YetAnotherElectronicsChannel/Discrete-PWM-Class-D/spice_filter_simulation.pdf

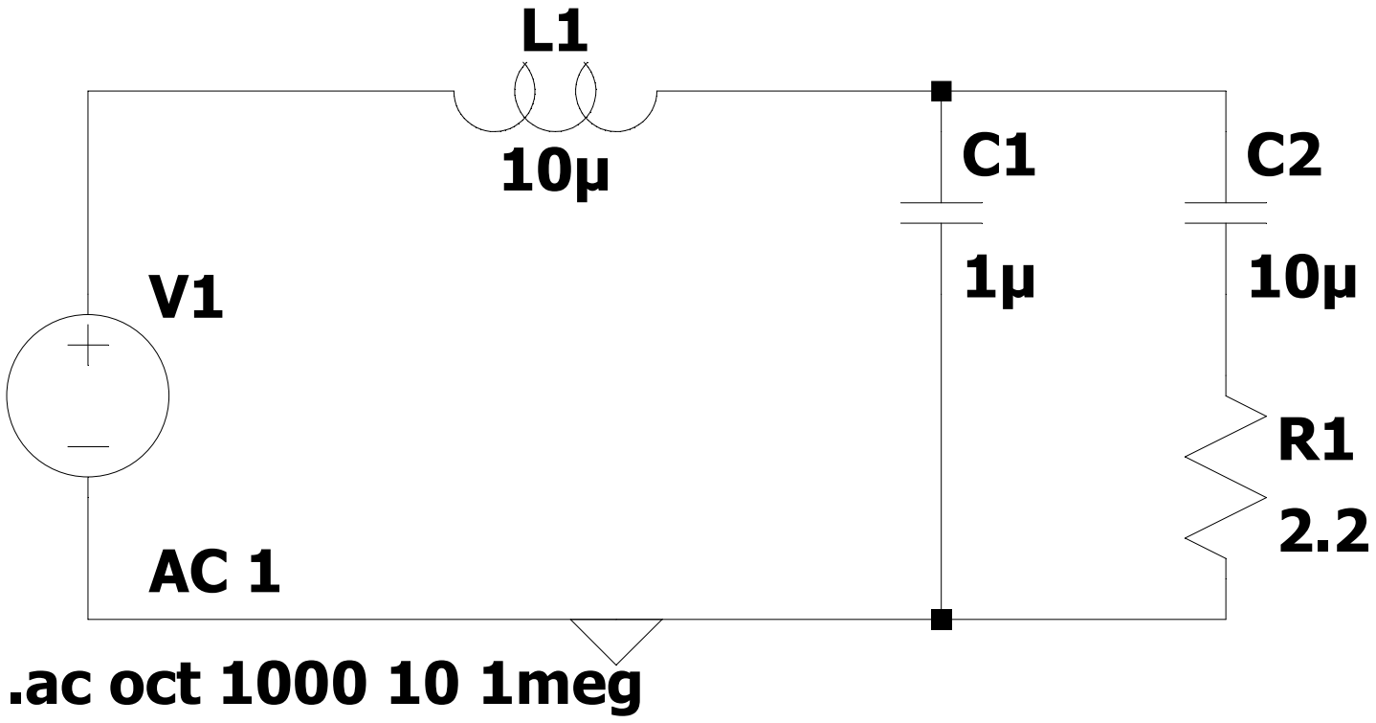
[picture p2: figure]
.ac oct 1000 10 1meg

--- E:\spice\youtube_classd_filter.asc ---
