YetAnotherElectronicsChannel/Discrete-PWM-Class-D/PWM Class-D Concept.pdf

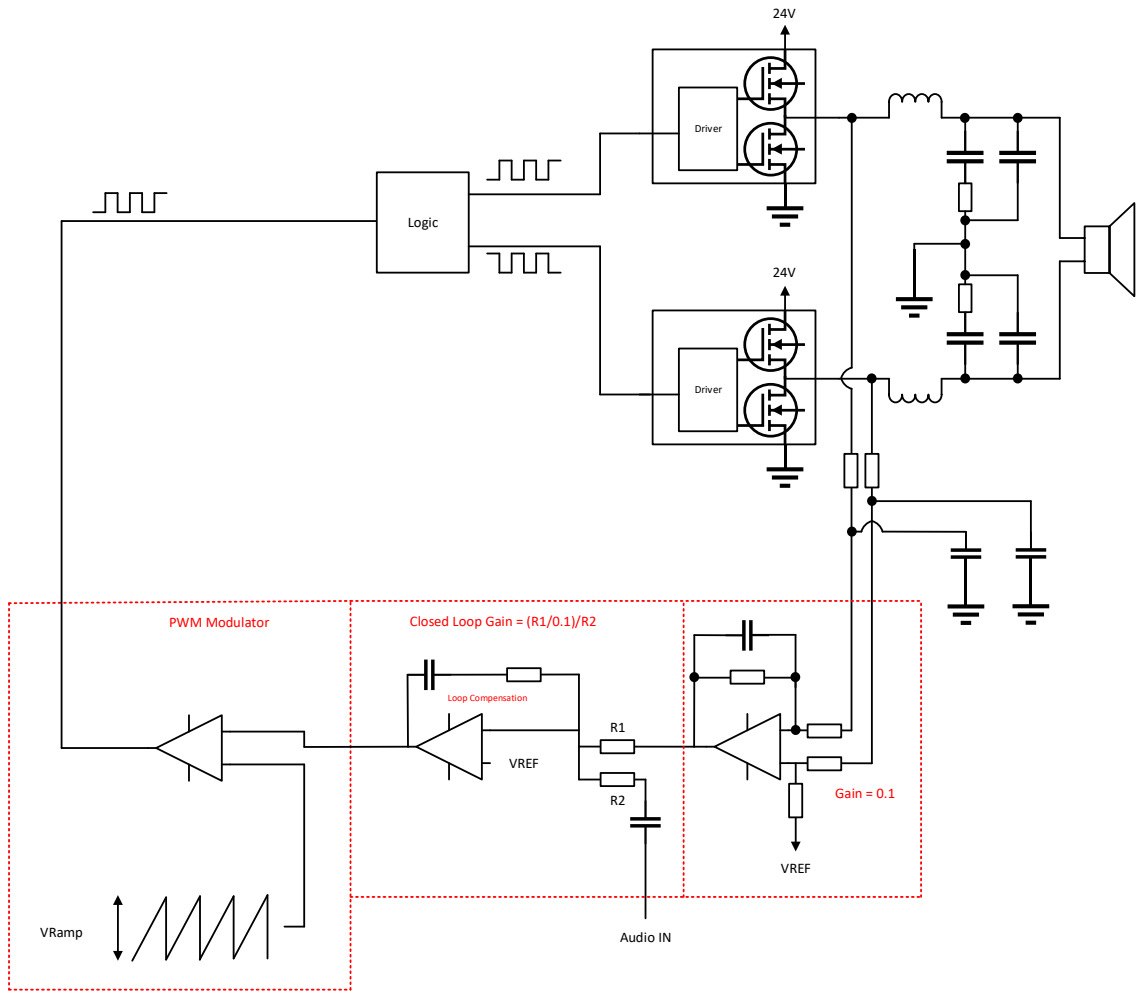
[picture p3: page 1]
Driver; VREF; Audio IN; Gain = 0.1; Loop Compensation; VRamp; Logic; PWM Modulator

Closed Loop Gain = (R1/0.1)/R2
