YetAnotherElectronicsChannel/Discrete-PWM-Class-D/Schematic.pdf

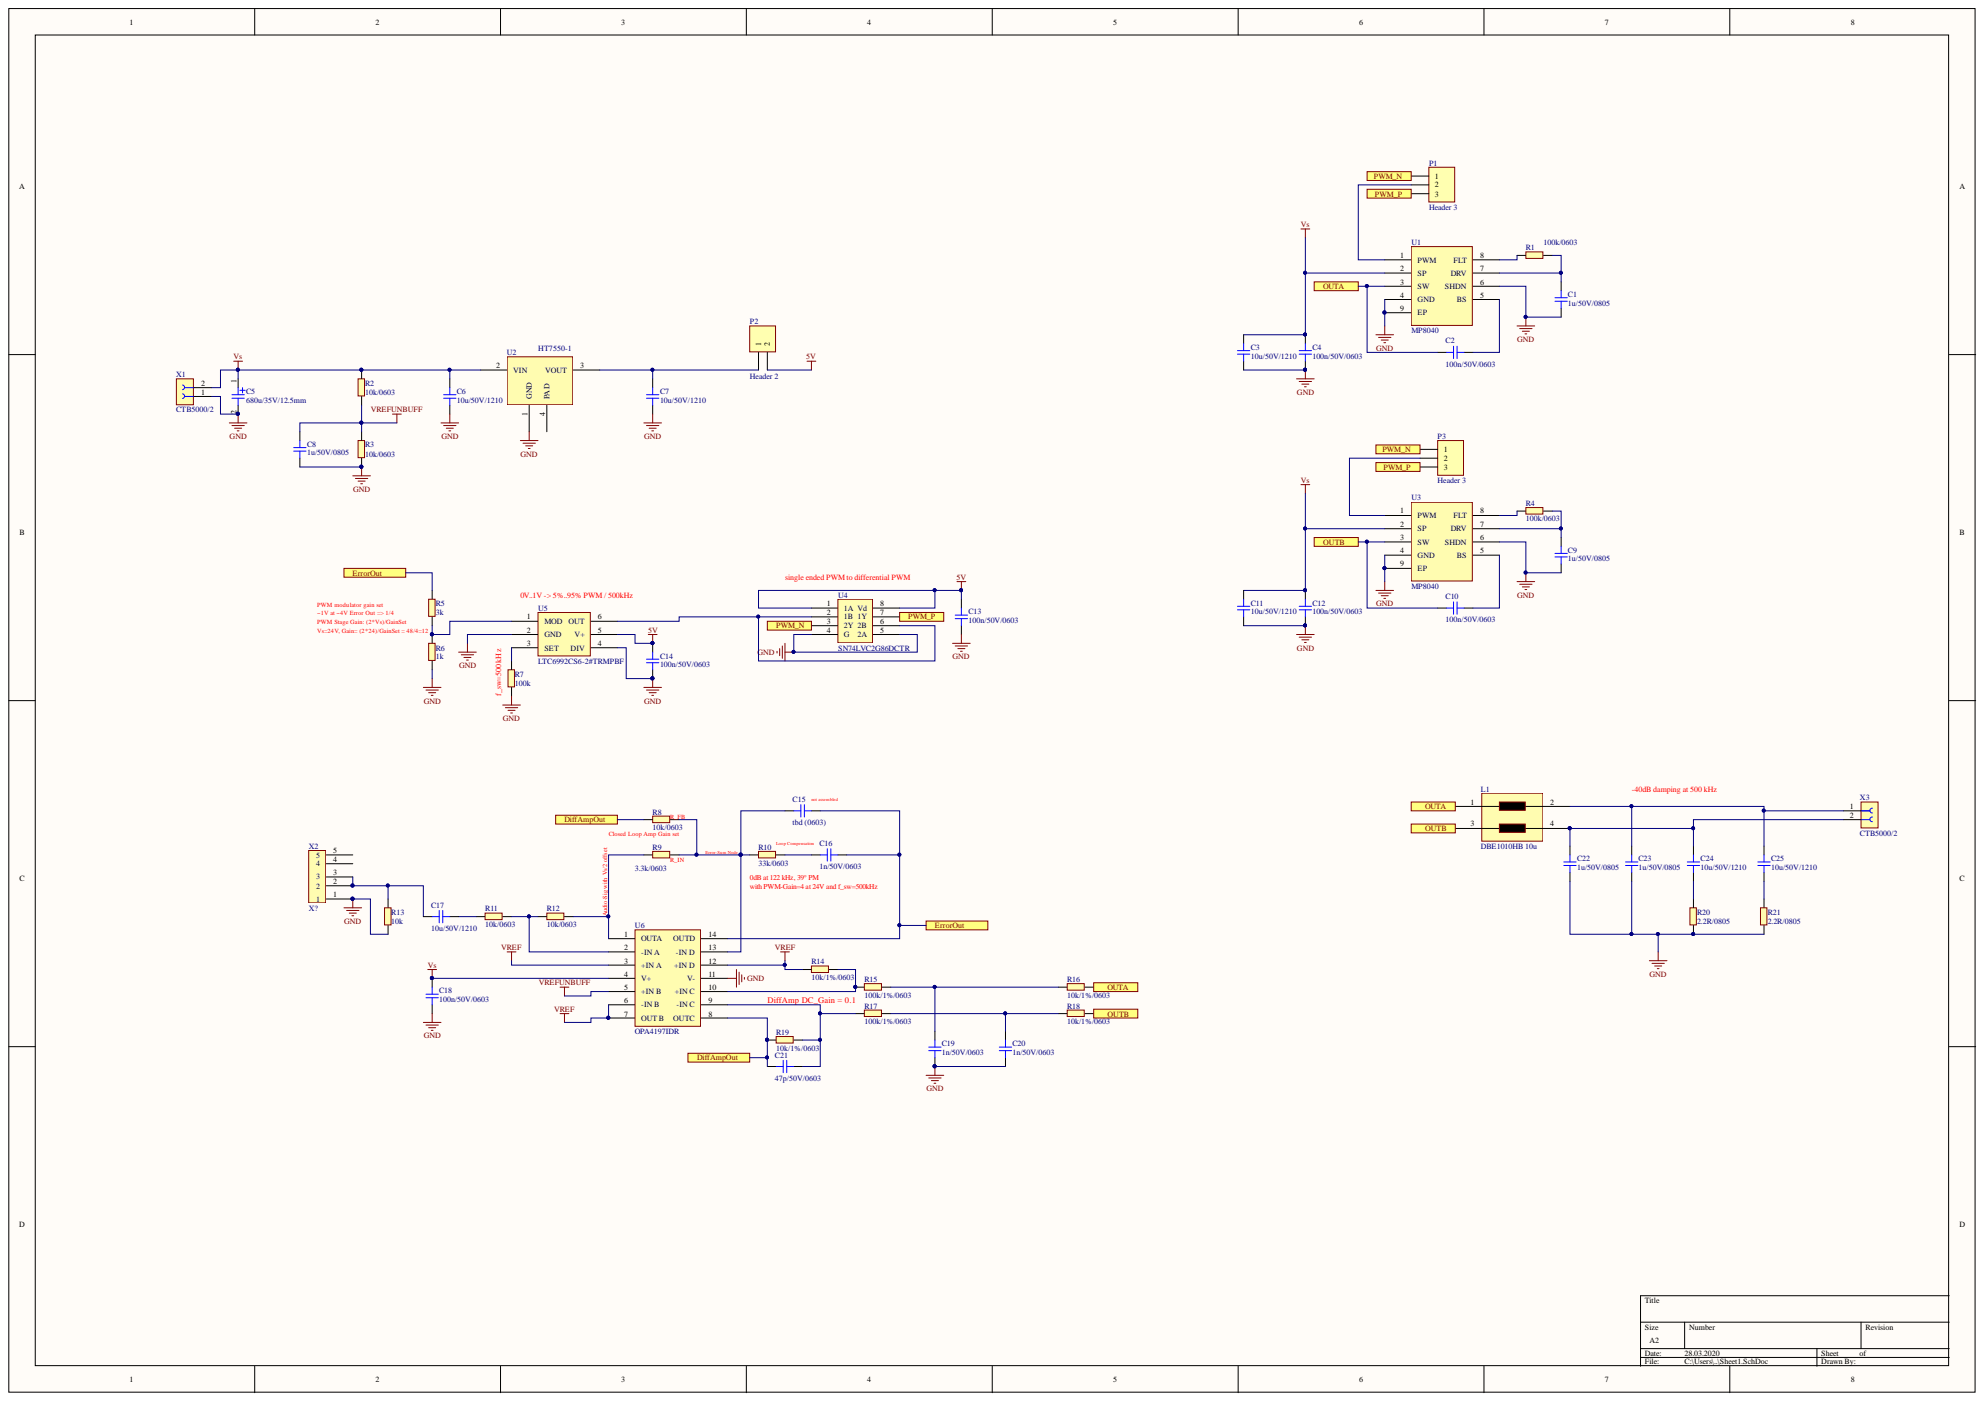
[picture p4: page 1]

single ended PWM to differential PWM

PWM modulator gain set
~1V at ~4V Error Out => 1/4
PWM Stage Gain: (2*Vs)/GainSet
Vs=24V, Gain= (2*24)/GainSet = 48/4=12

Closed Loop Amp Gain set

Audio-Sig with Vs/2 offset

0dB at 122 kHz, 39° PM
with PWM-Gain=4 at 24V and f_sw=500kHz
