YetAnotherElectronicsChannel/Discrete-PWM-Class-D/spice_schematic_transient_simulation.pdf

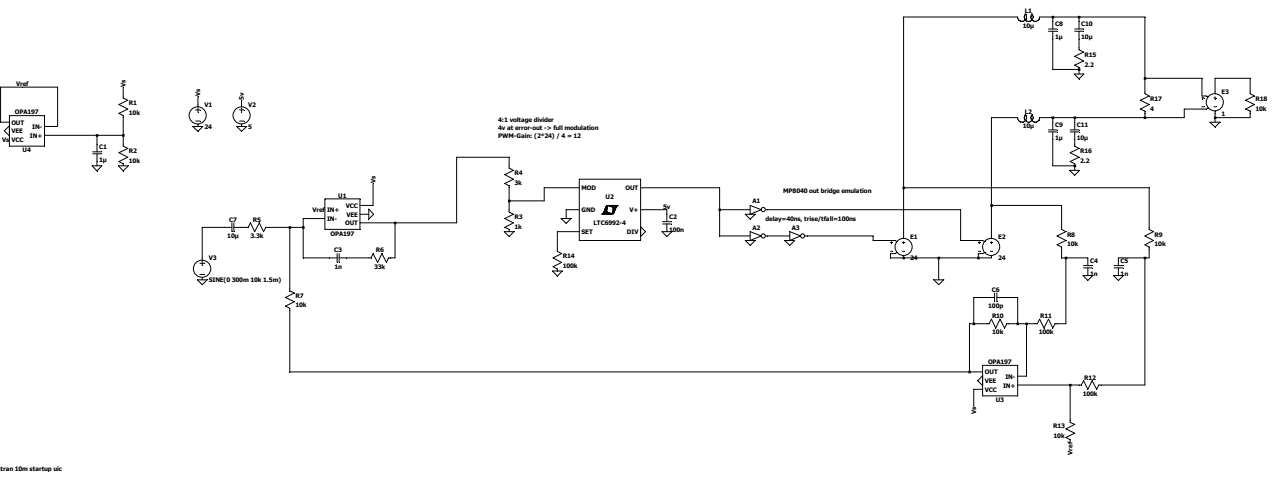
[picture p5: page 1]

4:1 voltage divider
4v at error-out -> full modulation
PWM-Gain: (2*24) / 4 = 12
