YetAnotherElectronicsChannel/Discrete-PWM-Class-D/spice_schematic_ac_simulation.pdf

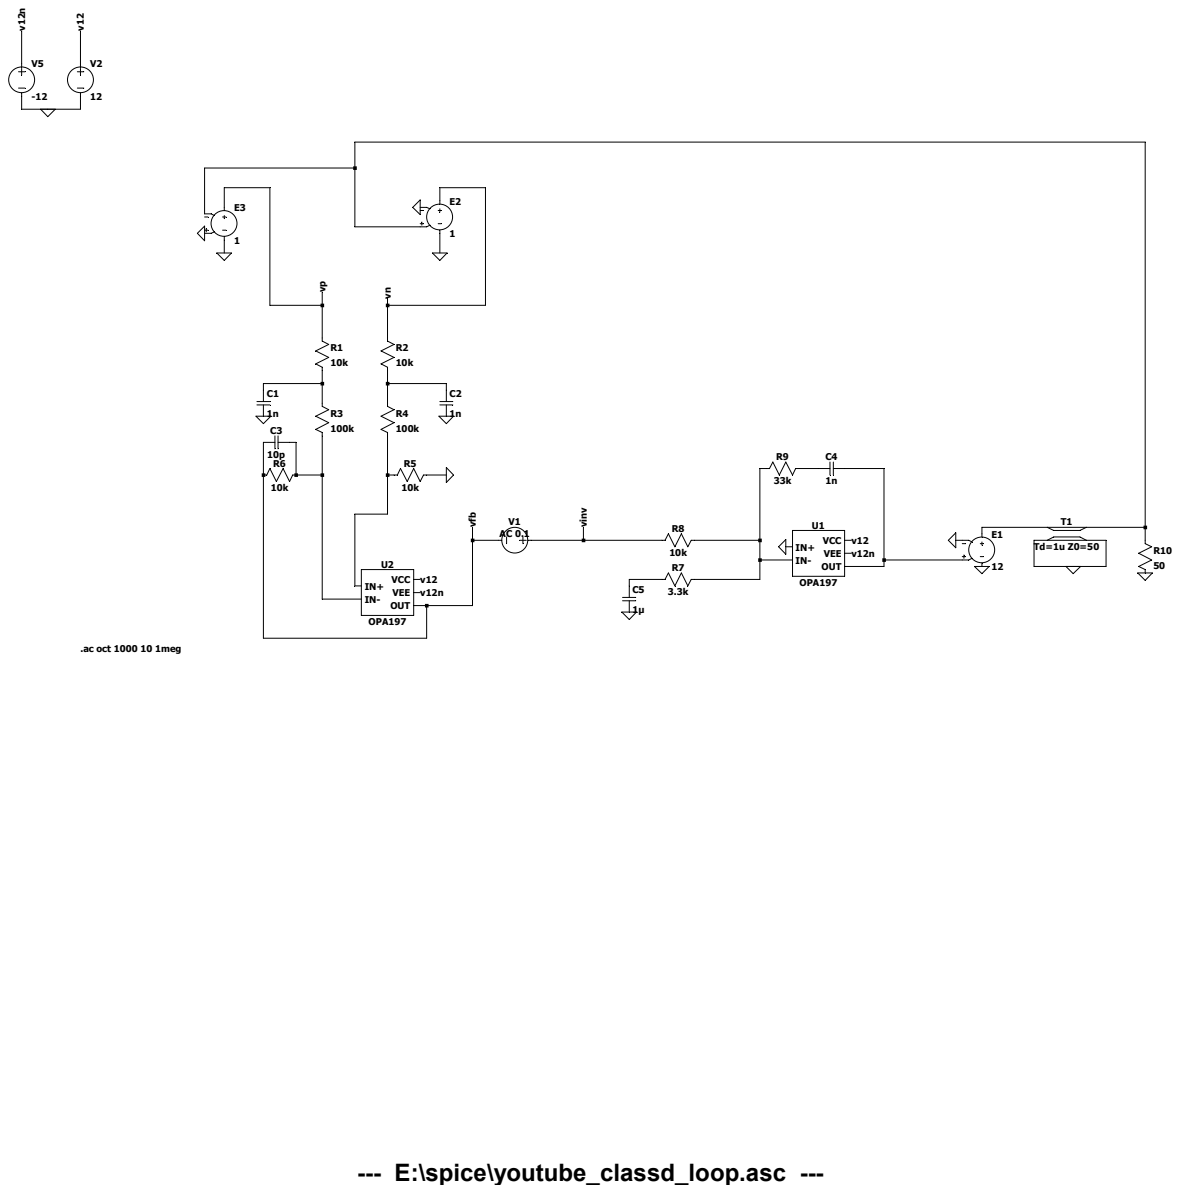
[picture p6: page 1]
