YetAnotherElectronicsChannel/Discrete-PWM-Class-D/spice_schematic_transient_simulation.asc

A1: inv; Td=40n Trise=100n Tfall=100n
A2: inv
A3: inv; Td=40n Tfall=100n Trise=100n
C1: cap; 1µ; Lser=IC=12
C2: cap; 100n
C3: cap; 1n
C4: cap; 1n
C5: cap; 1n
C6: cap; 100p
C7: cap; 10µ; Rser=IC=12
C8: cap; 1µ
C9: cap; 1µ
C10: cap; 10µ
C11: cap; 10µ
E1: e; 24
E2: e; 24
E3: e; 1
L1: ind; 10µ
L2: ind; 10µ
R1: res; 10k
R2: res; 10k
R3: res; 1k
R4: res; 3k
R5: res; 3.3k
R6: res; 33k
R7: res; 10k
R8: res; 10k
R9: res; 10k
R10: res; 10k
R11: res; 100k
R12: res; 100k
R13: res; 10k
R14: res; 100k
R15: res; 2.2
R16: res; 2.2
R17: res; 4
R18: res; 10k
U1: OPA197
U2: LTC6992-4
U3: OPA197
U4: OPA197
V1: voltage; 24
V2: voltage; 5
V3: voltage; SINE(0 300m 10k 1.5m)
Named nets: 0, Vs, 5v, Vref
.tran 10m startup uic
delay=40ns, trise/tfall=100ns
4:1 voltage divider
4v at error-out -> full modulation
PWM-Gain: (2*24) / 4 = 12
MP8040 out bridge emulation
