YetAnotherElectronicsChannel/Discrete-PWM-Class-D/spice_schematic_ac_simulation.asc

C1: cap; 1n
C2: cap; 1n
C3: cap; 10p
C4: cap; 1n
C5: cap; 1µ
E1: e2; 12
E2: e2; 1
E3: e2; 1
R1: res; 10k
R2: res; 10k
R3: res; 100k
R4: res; 100k
R5: res; 10k
R6: res; 10k
R7: res; 3.3k
R8: res; 10k
R9: res; 33k
R10: res; 50
T1: tline; Td=1u Z0=50
U1: OPA197
U2: OPA197
V1: voltage; ""; AC 0.1
V2: voltage; 12
V5: voltage; -12
Named nets: 0, v12, vinv, vfb, vp, vn, v12n
.ac oct 1000 10 1meg
