YetAnotherElectronicsChannel/Discrete-PWM-Class-D/spice_filter_simulation.asc

C1: cap; 1µ
C2: cap; 10µ
L1: ind; 10µ; Rser=20m
R1: res; 2.2
V1: voltage; ""; AC 1
Named nets: 0
.ac oct 1000 10 1meg
