YetAnotherElectronicsChannel/Discrete-PWM-Class-D/measurement_gain_800mv_pp_in.png

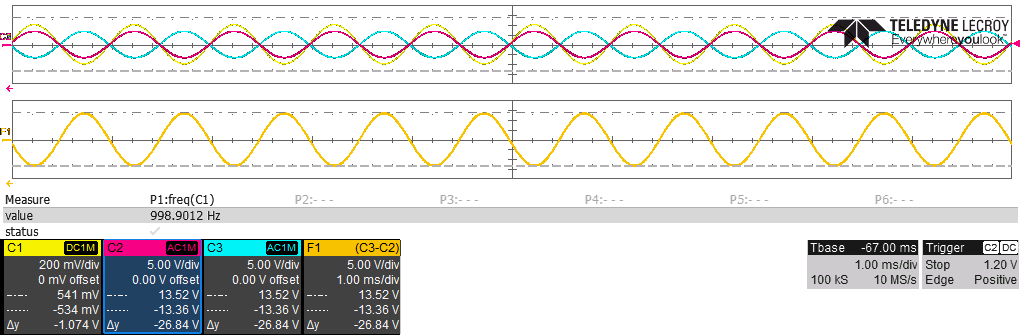
measurement_gain_800mv_pp_in.png
