YetAnotherElectronicsChannel/Discrete-PWM-Class-D/measurement_max-voltage-unclipped-4ohm.png

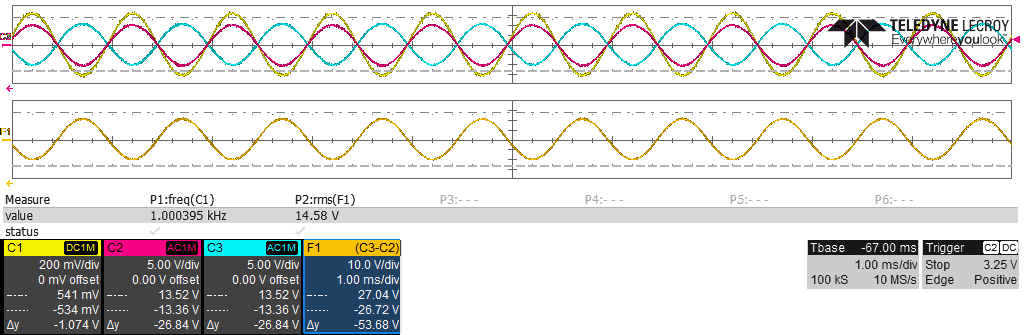
measurement_max-voltage-unclipped-4ohm.png
