YetAnotherElectronicsChannel/Discrete-PWM-Class-D/measurement_thd-1w-4ohm-1khz-time.png

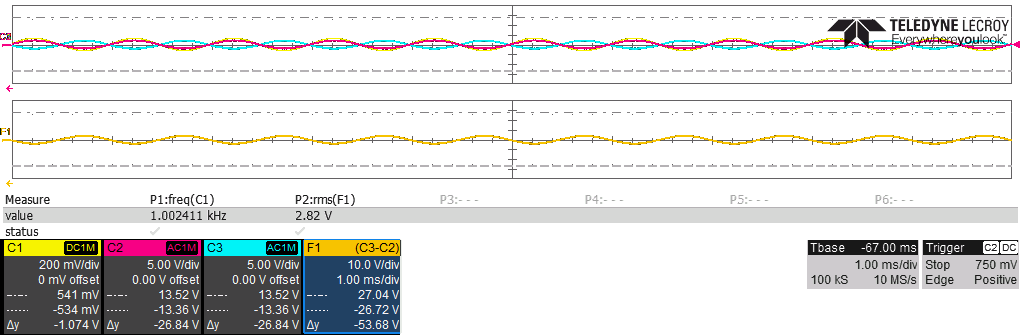
measurement_thd-1w-4ohm-1khz-time.png
