YetAnotherElectronicsChannel/Discrete-PWM-Class-D/measurement_thd-10w-4ohm-1khz.png

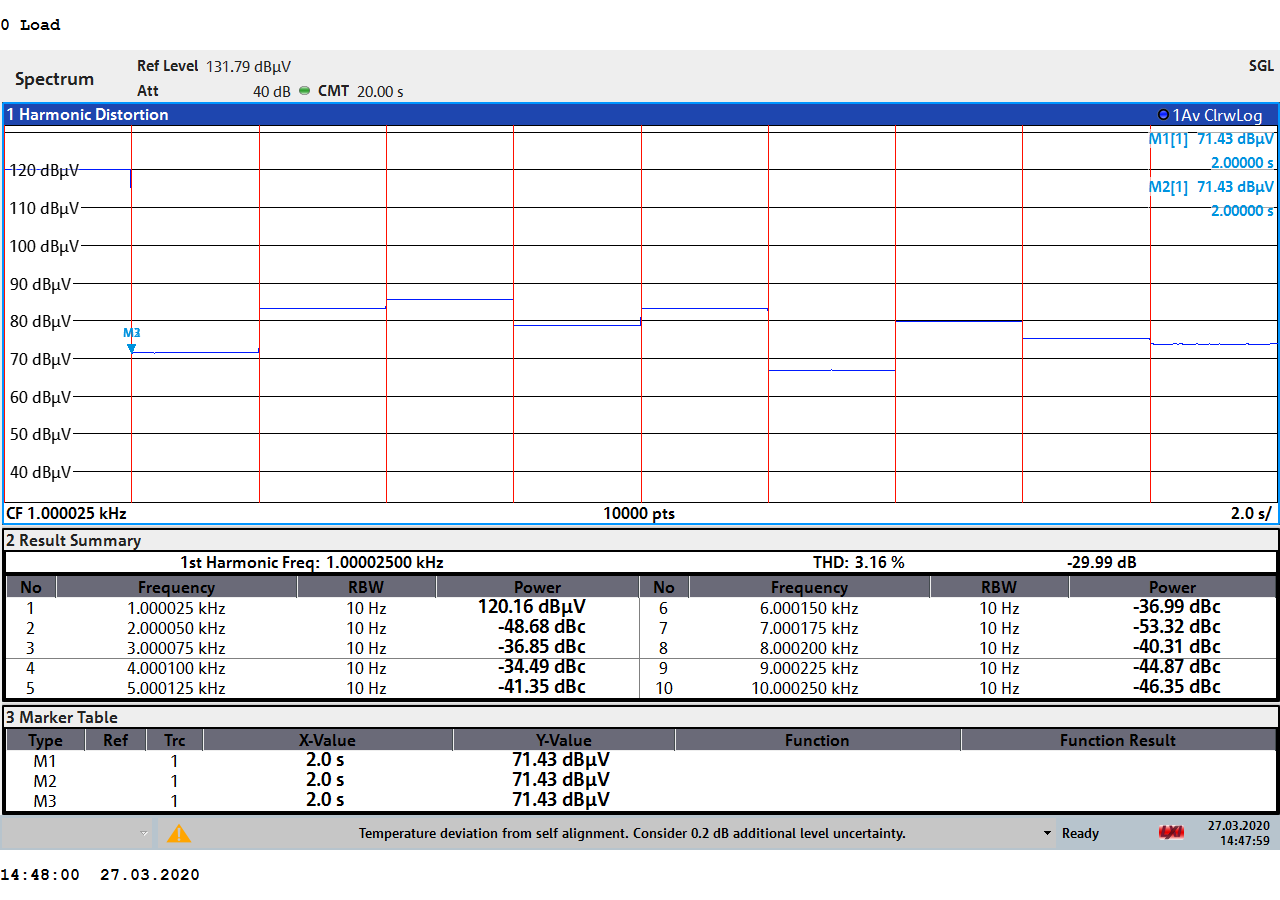
measurement_thd-10w-4ohm-1khz.png
