YetAnotherElectronicsChannel/Discrete-PWM-Class-D/measurement_thd-25w-4ohm-1khz.PNG

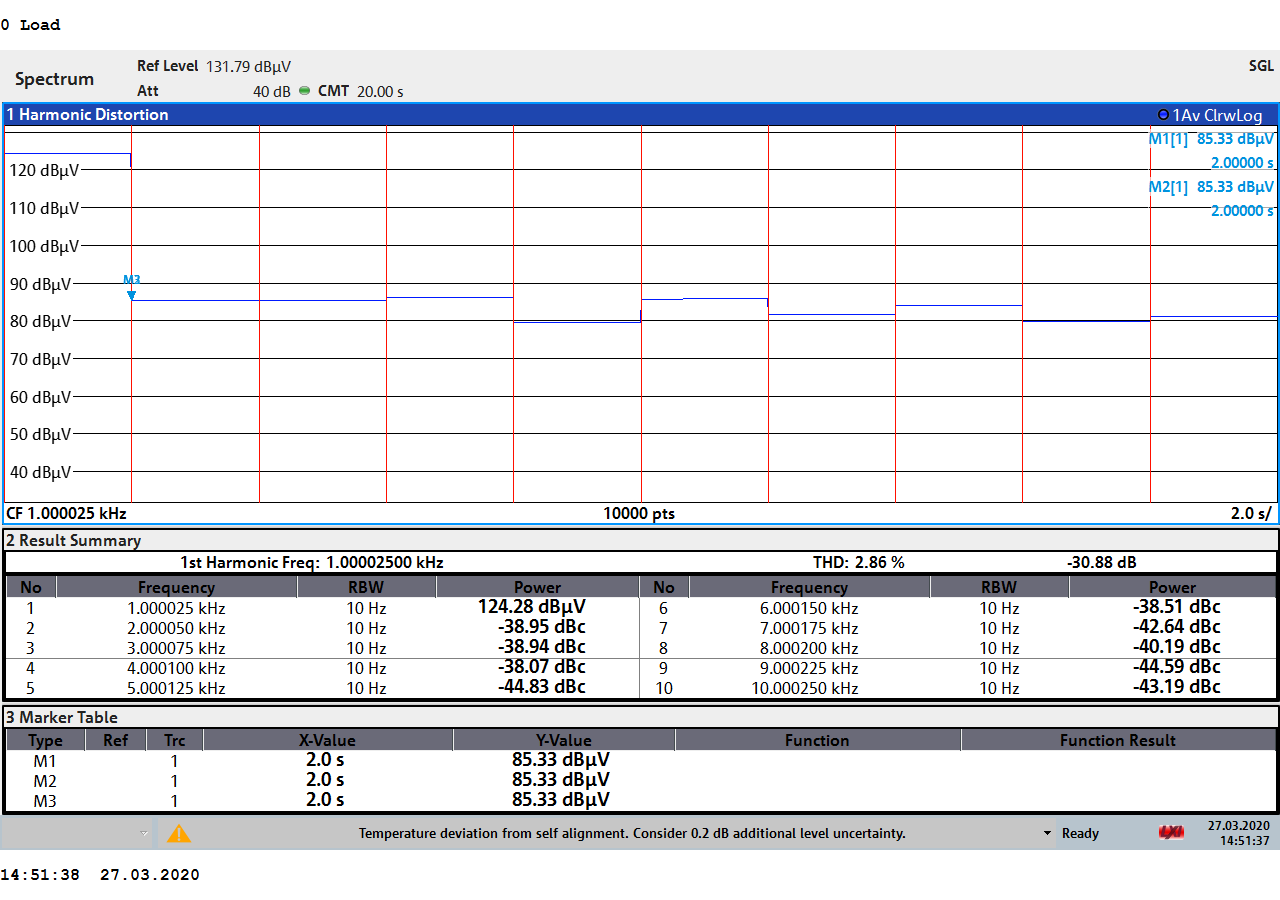
measurement_thd-25w-4ohm-1khz.PNG
