YetAnotherElectronicsChannel/Discrete-PWM-Class-D/Summary_Measurements.PNG

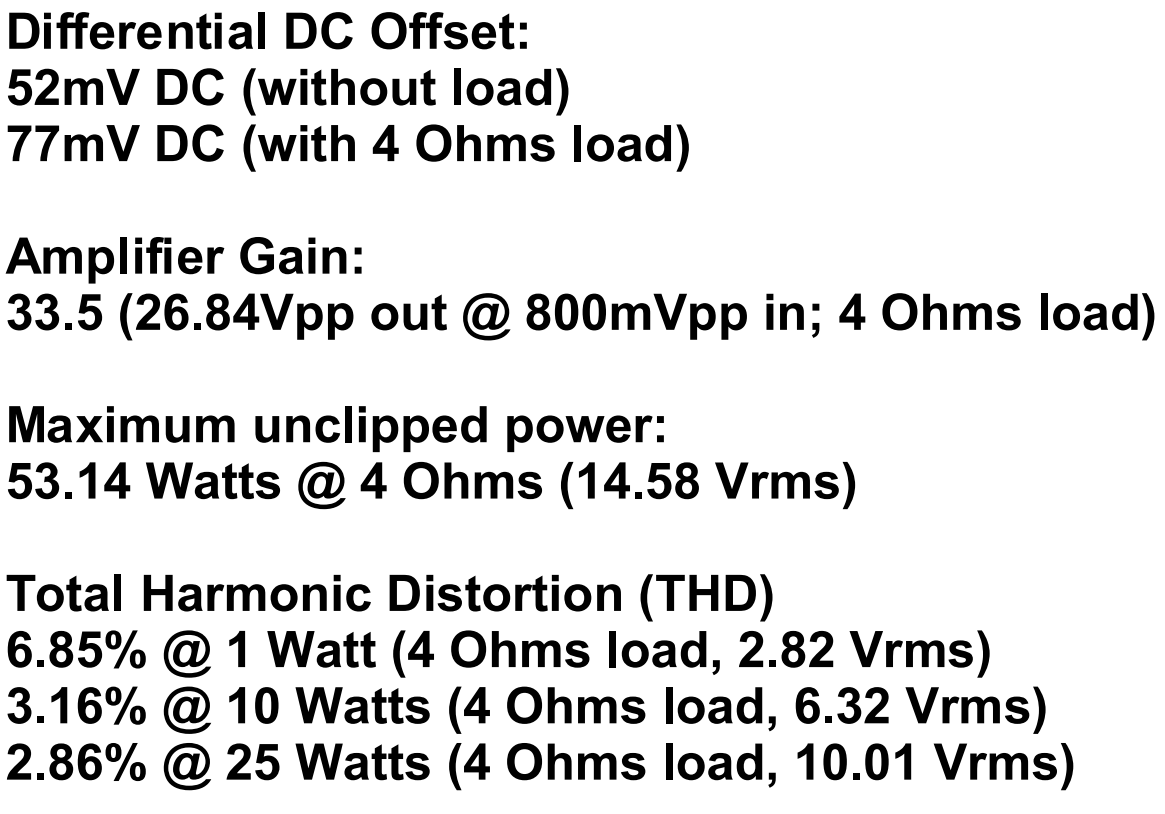
Summary_Measurements.PNG
